rickh87/HPROM-Programmer/Family 2 Programmer ver2.docx

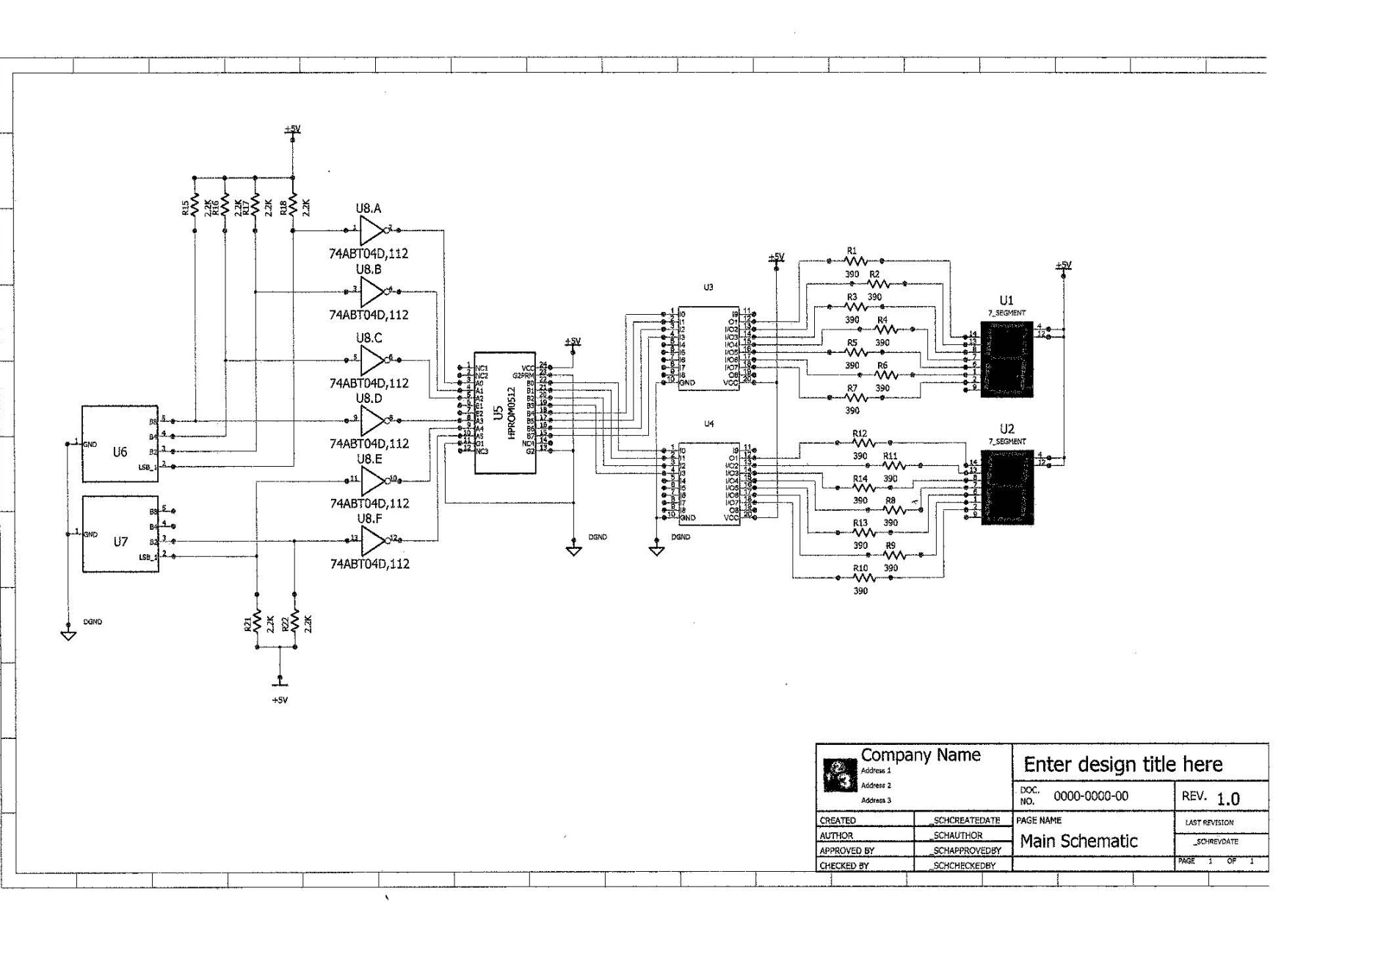
[picture p6: figure]
